Nero-gif/Linefollower/LF_4.0 - 26nat/Documentation/TechDraw.pdf

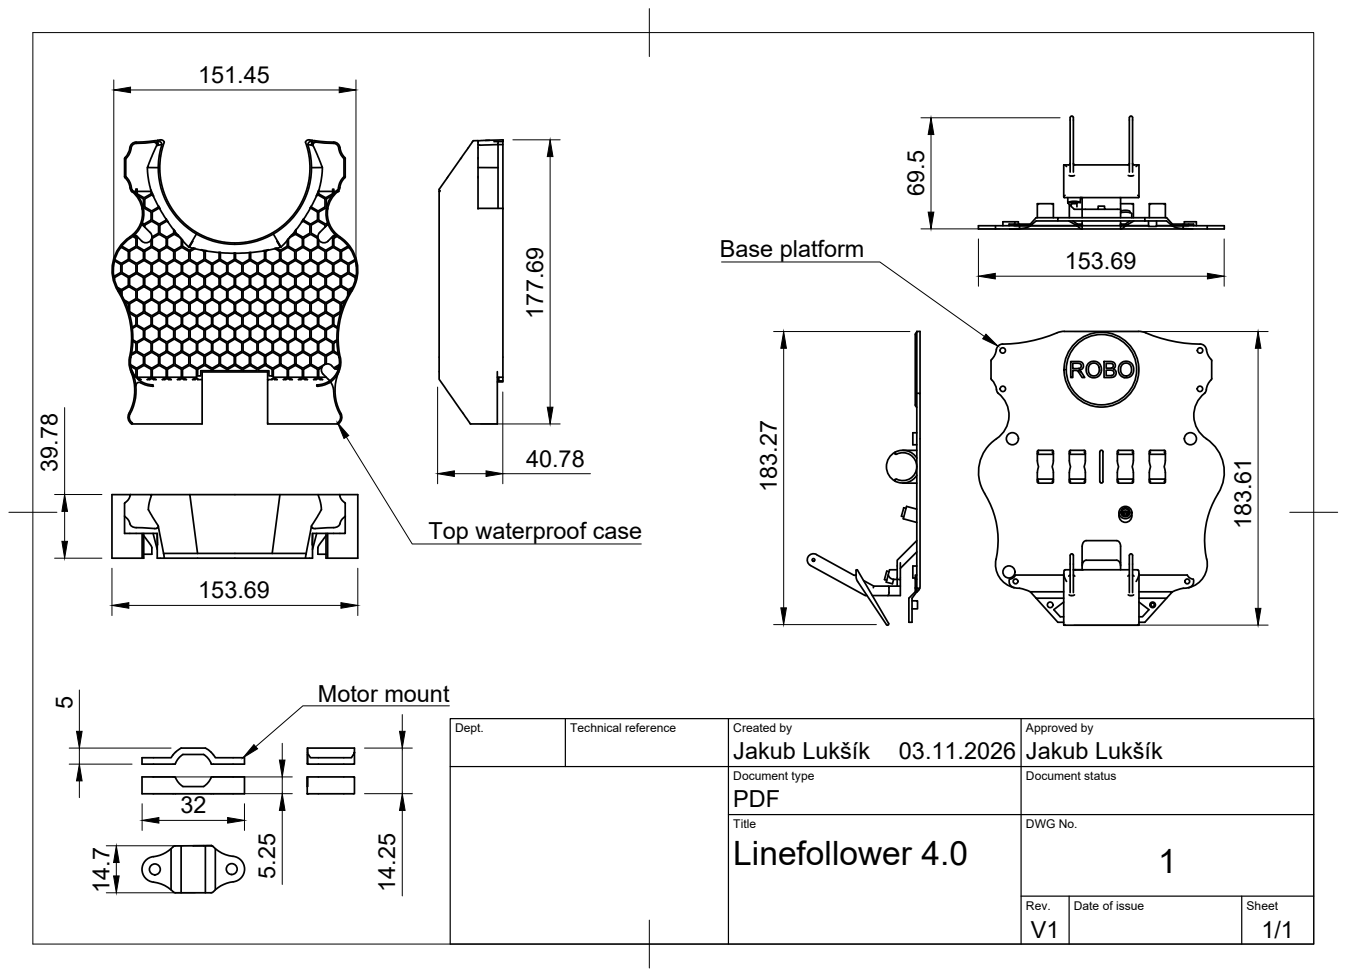
[picture p1: page 1]
Base platform; Motor mount

Top waterproof case

Dept. | Technical reference | Created by Jakub Lukšík 03.11.2026 | Approved by Jakub Lukšík

Document type PDF | Document status

Title Linefollower 4.0 | DWG No. 1

Rev. V1 | Date of issue | Sheet 1/1
