Nero-gif/Linefollower/LF_4.0 - 26nat/Documentation/LF_CB_modular_v1_competition.pdf

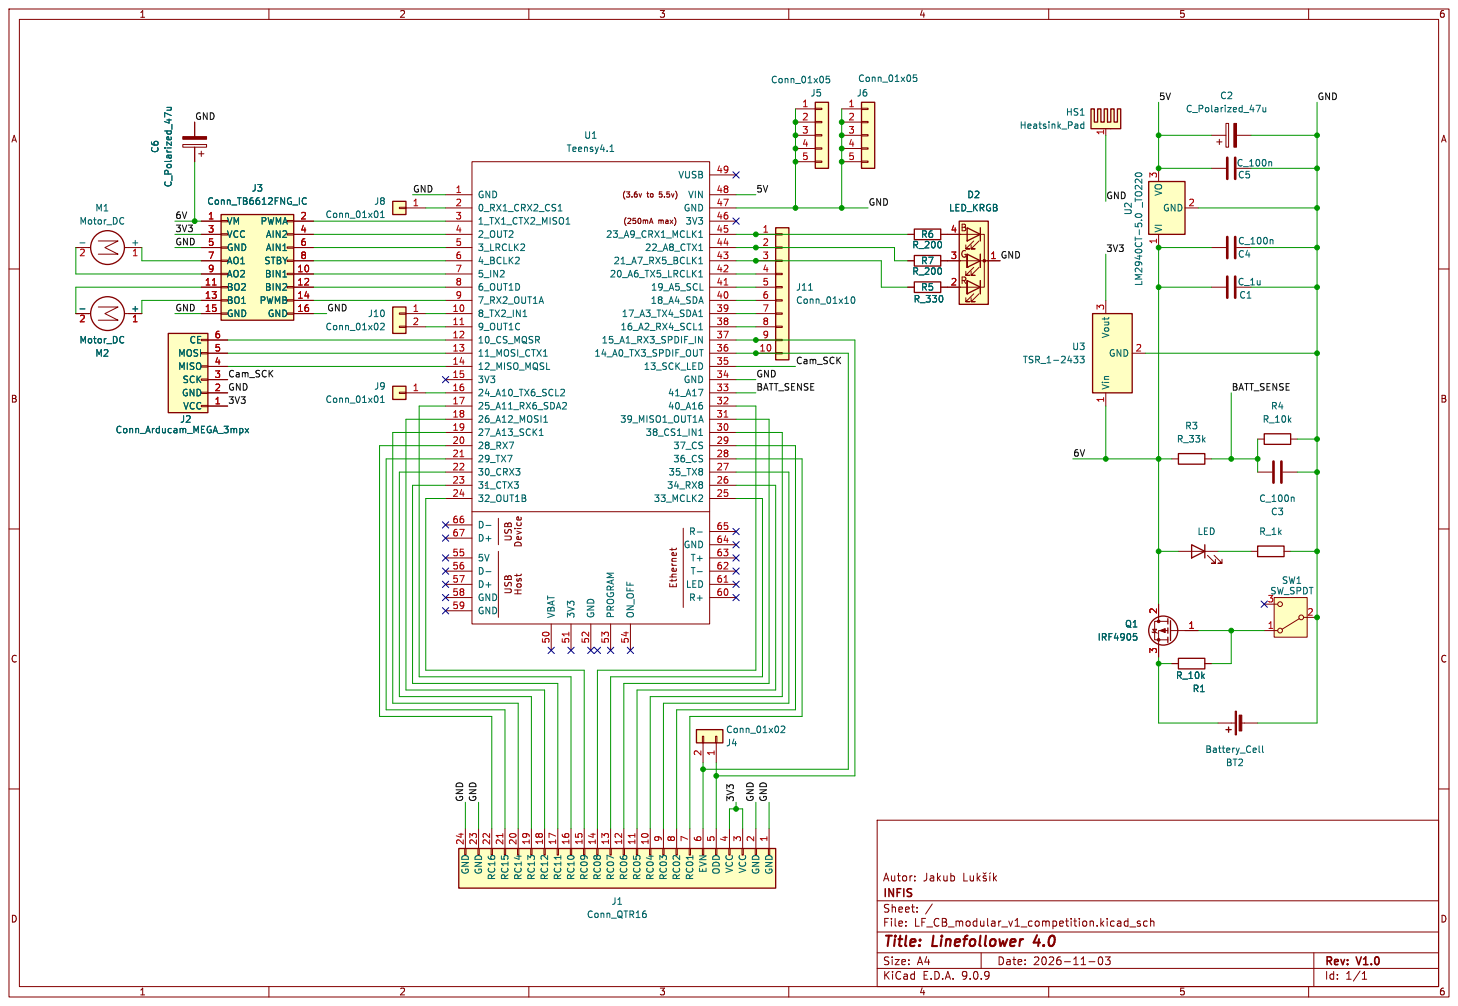
[picture p2: page 1]
