Nero-gif/Linefollower/LF_4.0 - 26nat/KiCad/LF_CB_modular_v1/LF_CB_modular_v1.kicad_pcb

## KiCad design LF_4.0 - 26nat/KiCad/LF_CB_modular_v1/LF_CB_modular_v1.kicad_pcb (2026-10-15)

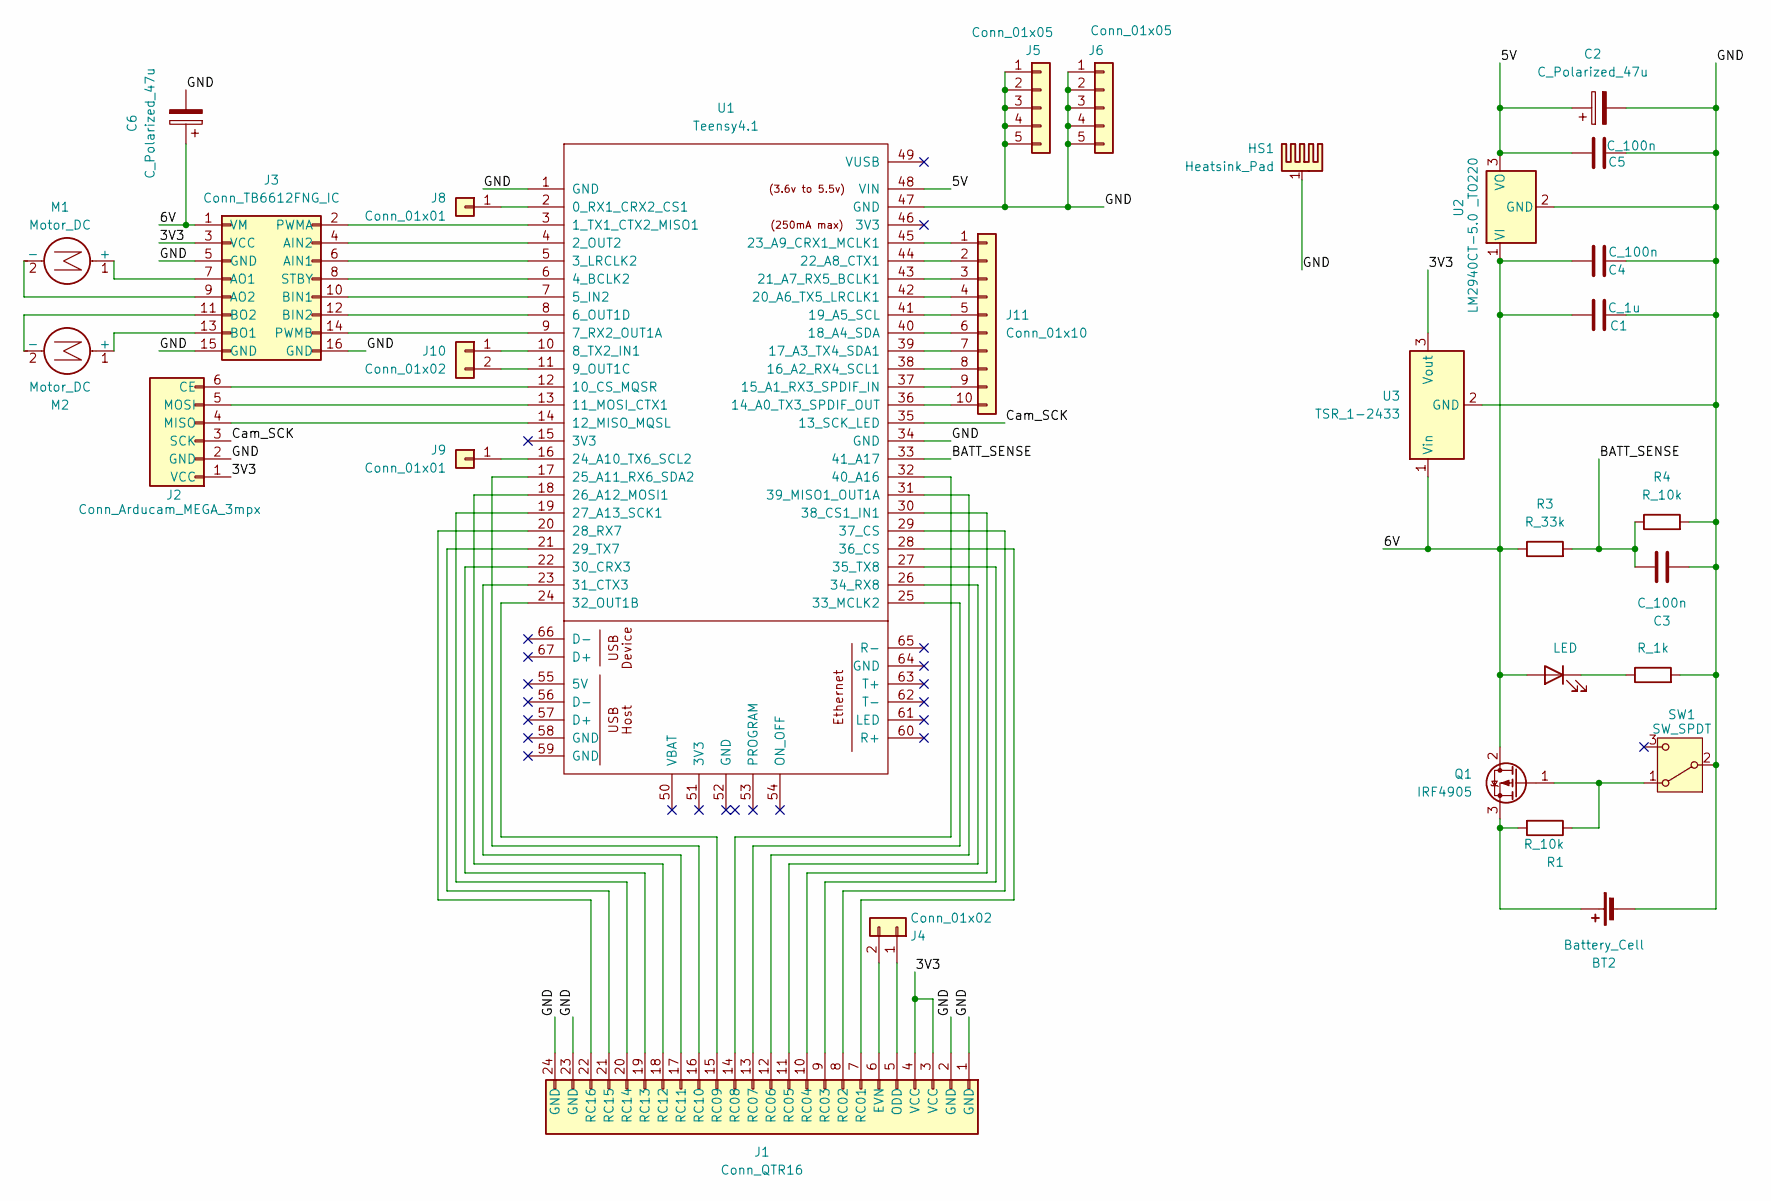
[picture p3: schematic LF_CB_modular_v1.kicad_sch]

Parts:
BT2: Battery_Cell; SolderWire-2sqmm_1x02_P7.8mm_D2mm_OD3.9mm
C1: C_1u; C_Disc_D5.0mm_W2.5mm_P5.00mm
C2, C6: C_Polarized_47u; CP_Radial_D6.3mm_P2.50mm
C3, C4, C5: C_100n; C_Disc_D4.3mm_W1.9mm_P5.00mm
D1: LED; LED_D5.0mm
HS1: Heatsink_Pad; Heatsink_HS-123-25_TO220_STONECOLD
J1: Conn_QTR16; IDC-Header_2x12_P2.54mm_Vertical
J2: Conn_Arducam_MEGA_3mpx; JST_XH_B6B-XH-A_1x06_P2.50mm_Vertical
J3: Conn_TB6612FNG_IC; PinHeader_TB6612FNG_IC
J4, J10: Conn_01x02; PinSocket_1x02_P2.54mm_Vertical
J5, J6: Conn_01x05; PinSocket_1x05_P2.54mm_Vertical
J8, J9: Conn_01x01; PinSocket_1x01_P2.54mm_Vertical
J11: Conn_01x10; PinSocket_1x10_P2.54mm_Vertical
M1, M2: Motor_DC; JST_XH_B2B-XH-A_1x02_P2.50mm_Vertical
Q1: IRF4905; TO-220-3_Vertical
R1, R4: R_10k; R_Axial_DIN0204_L3.6mm_D1.6mm_P7.62mm_Horizontal
R2: R_1k; R_Axial_DIN0204_L3.6mm_D1.6mm_P7.62mm_Horizontal
R3: R_33k; R_Axial_DIN0204_L3.6mm_D1.6mm_P7.62mm_Horizontal
SW1: SW_SPDT; JST_XH_B2B-XH-A_1x02_P2.50mm_Vertical
U1: Teensy4.1; Teensy41_lite
U2: LM2940CT-5.0 _TO220; TO-220-3_Vertical
U3: TSR_1-2433; Converter_DCDC_TRACO_TSR-1_THT

Connections:
/3V3: J1.3 (VCC), J1.4 (VCC), J2.1 (VCC), J3.3 (VCC), U3.3 (Vout)
/5V: C2.1, C5.2, U1.48 (VIN), U2.3 (VO)
/6V: C1.1, C4.2, C6.1, D1.2 (A), J3.1 (VM), Q1.2 (D), R3.1, U2.1 (VI), U3.1 (Vin)
/BATT_SENSE: C3.2, R3.2, R4.1, U1.33 (41_A17)
/Cam_SCK: J2.3 (SCK), U1.35 (13_SCK_LED)
/GND: BT2.2 (-), C1.2, C2.2, C3.1, C4.1, C5.1, C6.2, HS1.1, J1.1 (GND), J1.2 (GND), J1.23 (GND), J1.24 (GND), J2.2 (GND), J3.5 (GND), J3.15 (GND), J3.16 (GND), J5.1, J5.2, J5.3, J5.4, J5.5, J6.1, J6.2, J6.3, J6.4, J6.5, R2.2, R4.2, SW1.2 (B), U1.1 (GND), U1.34 (GND), U1.47 (GND), U2.2 (GND), U3.2 (GND)
unnamed: BT2.1 (+), Q1.3 (S), R1.2
unnamed: D1.1 (K), R2.1
unnamed: J1.6 (EVN), J4.2
unnamed: J1.5 (ODD), J4.1
unnamed: J1.7 (RC01), U1.28 (36_CS)
unnamed: J1.8 (RC02), U1.29 (37_CS)
unnamed: J1.9 (RC03), U1.27 (35_TX8)
unnamed: J1.10 (RC04), U1.30 (38_CS1_IN1)
unnamed: J1.11 (RC05), U1.26 (34_RX8)
unnamed: J1.12 (RC06), U1.31 (39_MISO1_OUT1A)
unnamed: J1.13 (RC07), U1.25 (33_MCLK2)
unnamed: J1.14 (RC08), U1.32 (40_A16)
unnamed: J1.15 (RC09), U1.24 (32_OUT1B)
unnamed: J1.16 (RC10), U1.17 (25_A11_RX6_SDA2)
unnamed: J1.17 (RC11), U1.23 (31_CTX3)
unnamed: J1.18 (RC12), U1.18 (26_A12_MOSI1)
unnamed: J1.19 (RC13), U1.22 (30_CRX3)
unnamed: J1.20 (RC14), U1.19 (27_A13_SCK1)
unnamed: J1.21 (RC15), U1.21 (29_TX7)
unnamed: J1.22 (RC16), U1.20 (28_RX7)
unnamed: J2.6 (CE), U1.12 (10_CS_MQSR)
unnamed: J2.4 (MISO), U1.14 (12_MISO_MQSL)
unnamed: J2.5 (MOSI), U1.13 (11_MOSI_CTX1)
unnamed: J3.6 (AIN1), U1.5 (3_LRCLK2)
unnamed: J3.4 (AIN2), U1.4 (2_OUT2)
unnamed: J3.7 (AO1), M1.1 (+)
unnamed: J3.9 (AO2), M1.2 (-)
unnamed: J3.10 (BIN1), U1.7 (5_IN2)
unnamed: J3.12 (BIN2), U1.8 (6_OUT1D)
unnamed: J3.13 (BO1), M2.1 (+)
unnamed: J3.11 (BO2), M2.2 (-)
unnamed: J3.2 (PWMA), U1.3 (1_TX1_CTX2_MISO1)
unnamed: J3.14 (PWMB), U1.9 (7_RX2_OUT1A)
unnamed: J3.8 (STBY), U1.6 (4_BCLK2)
unnamed: J8.1, U1.2 (0_RX1_CRX2_CS1)
unnamed: J9.1, U1.16 (24_A10_TX6_SCL2)
unnamed: J10.1, U1.10 (8_TX2_IN1)
unnamed: J10.2, U1.11 (9_OUT1C)
unnamed: J11.1, U1.45 (23_A9_CRX1_MCLK1)
unnamed: J11.2, U1.44 (22_A8_CTX1)
unnamed: J11.3, U1.43 (21_A7_RX5_BCLK1)
unnamed: J11.4, U1.42 (20_A6_TX5_LRCLK1)
unnamed: J11.5, U1.41 (19_A5_SCL)
unnamed: J11.6, U1.40 (18_A4_SDA)
unnamed: J11.7, U1.39 (17_A3_TX4_SDA1)
unnamed: J11.8, U1.38 (16_A2_RX4_SCL1)
unnamed: J11.9, U1.37 (15_A1_RX3_SPDIF_IN)
unnamed: J11.10, U1.36 (14_A0_TX3_SPDIF_OUT)
unnamed: Q1.1 (G), R1.1, SW1.1 (A)

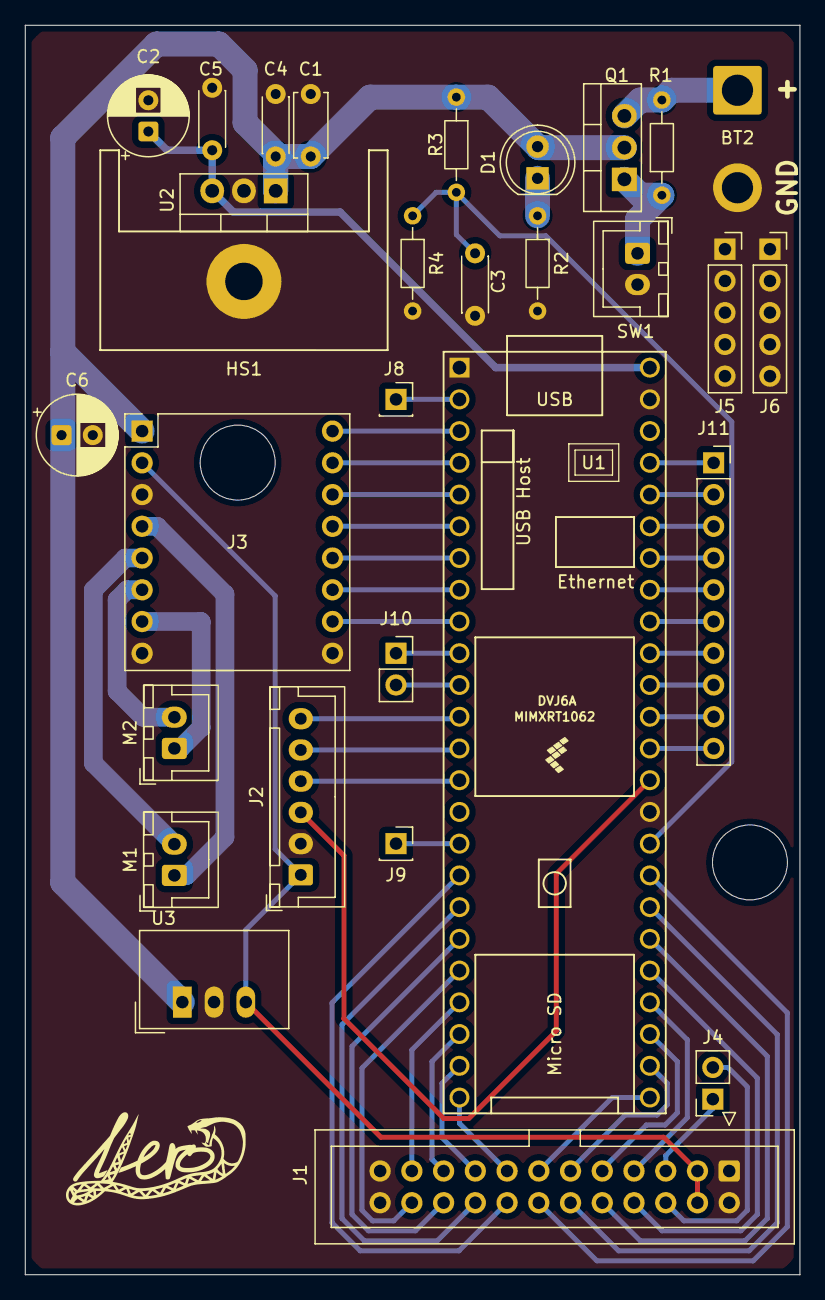
[picture p4: board LF_CB_modular_v1.kicad_pcb from above]

Board: 2 copper layers, 62.0 x 100.0 mm, 30 parts (0 on the bottom side), 55 nets.
