Nero-gif/Linefollower/(commit log)

2026-02-02 testing pico
2026-10-12 removing kicad backups
2026-10-12 removing kicad backups 2
2026-10-12 redesigned power module
2026-10-12 power modul finishing
2026-10-13 silkscreen aranged
2026-10-15 replaced XT60 by wire
2026-10-20 space for code, git ignore gerber
2026-11-05 low voltage beak, no stop
